EvannnX/dotbeats-case-studio/docs/assets/dotBeats-S14-mechanical-assembly.step

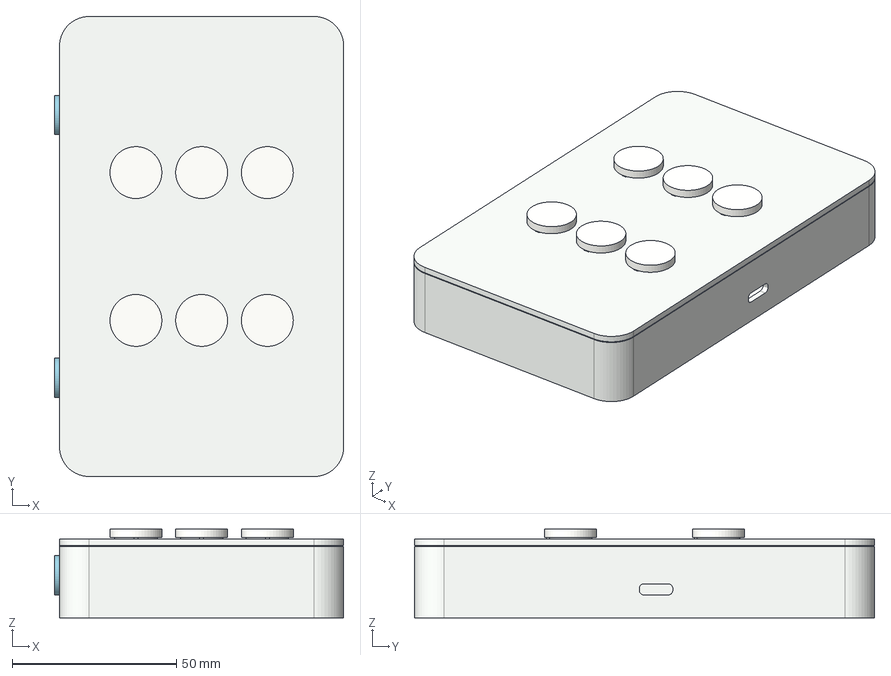
[picture p1: CAD file, 2026-11-09]
docs/assets/dotBeats-S14-mechanical-assembly.step
88.1 x 140.0 x 27.0 mm
base-S14
lid-S14
front_cap_1 x 6
front_carrier_1 x 6
side_cap_1 x 2
pcb_bush_1 x 3
