EvannnX/dotbeats-case-studio/(commit log)

2026-10-26 Publish dotBeats case studio, isolated models and bilingual mechanism videos
2026-10-26 Simplify public viewer to English 26mm assembly and hardware guide
2026-10-26 Add S01 side-button mounts, assembly preview and print package
2026-10-26 Publish S02 assembly guide and complete PCB mounting hardware
2026-10-28 Publish S03 centered front buttons and keyed offset carriers
2026-10-29 Publish S04 removable side-button trial and assembly animation
2026-11-09 Publish S14 standard case with captured side switches and fitted battery cradle
    [dotBeats-S14-mechanical-assembly.step]
